FlyyingPiggy2020/fp-tool/Readme.md

MCU：ESP32-S3-N16R8

LCD: STT89V

目前V1.0版本已知问题：

改进问题：1.ESD管的封装太小，手工焊接困难.2.Boot ,Reset按键未加私印。3.TVS管买错了应该是双向TVS管。4.USB的GND没连。5.USBd+ d-接反。

前三个问题不致命，tvs就算不焊接目前调试阶段工作也完全是正常的。第四点需要自己在USB口小心点加一坨锡，好在GND是最外面的两个引脚，直接焊一坨锡上去就行。

d+ d-接反的问题也在新版本中解决，目前先跳线调试软件。

这些问题计划在2.0版本中改进~~（如果有2.0的话）~~
