FlyyingPiggy2020/fp-tool/Hardware/Readme.md

原理图和PCB使用ad21制作。

gerber文件是交付给板厂的生产文件。

改进问题：1.ESD管的封装太小.2.Boot ,Reset按键未加私印。3.TVS管买错了。4USB GND没连
