FlyyingPiggy2020/fp-tool/Document/1.69吋显示屏/LCD三视图2.png

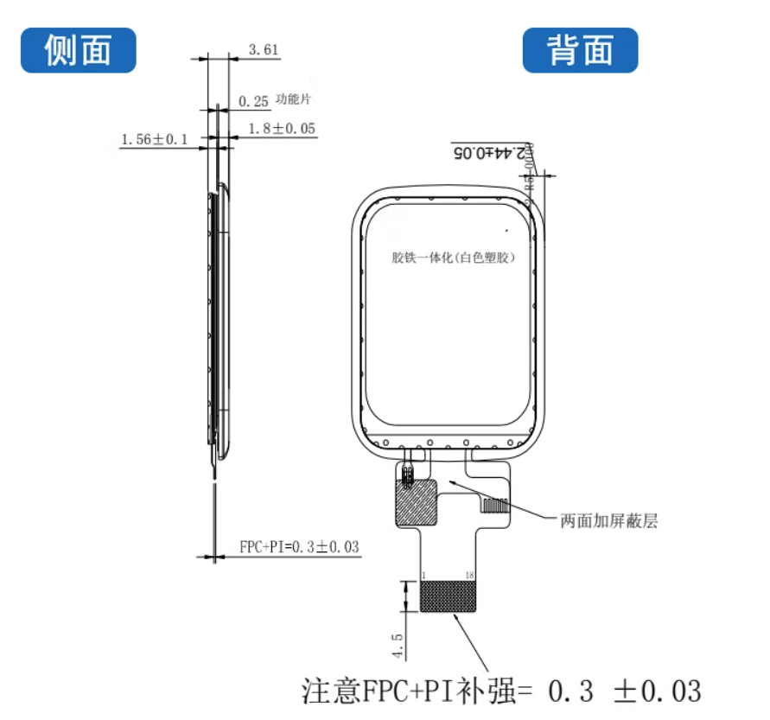
Document/1.69吋显示屏/LCD三视图2.png
