FlyyingPiggy2020/fp-tool/Document/1.69吋显示屏/LCD参数.png

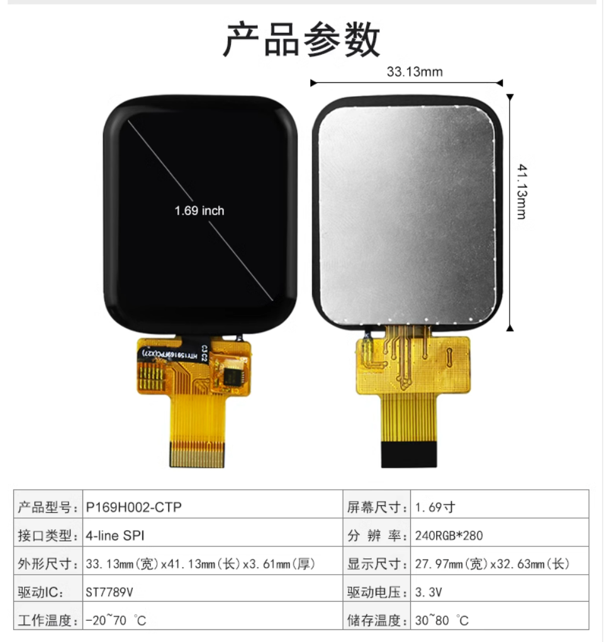
Document/1.69吋显示屏/LCD参数.png
