FlyyingPiggy2020/fp-tool/Hardware/fp-tool-bom.xlsx

Comment | Description | Designator | Footprint | LibRef | Quantity | 嘉立创物料编号
22uF | 贴片电容 | C1, C4, C7, C10, C13 | 0603_C | CAP_SMT | 5 | C2762594
1uF | 贴片电容 | C2 | 0603_C | CAP_SMT | 1 | C15849
47uF | 贴片电容 | C3, C6, C9, C12 | 0603_C | CAP_SMT | 4 | C140782
100nF | 贴片电容 | C5, C8, C11, C14,'C16, C18 | 0603_C | CAP_SMT | 6 | C14663
10uF | 贴片电容 | C15, C17 | 0603_C | CAP_SMT | 2 | C19702
B5819W |  | D1 | SOD-123F_L2.7-W1.6-LS3.8-RD-1 | B5819W | 1 | C2943878
LESD5D5.0CT1G |  | D2, D3, D4 | SOD-523_L1.2-W0.8-LS1.6-BI | LESD5D5.0CT1G | 3 | C383211
SMBJ6.0-170 | TVS | D5, D6, D7 | SMB(DO-214AA) - TVS | TVS | 3 | C726812
BAV99 |  | DN1 | SOT-23(SOT-23-3) | BAV99 | 1 | C82480
贴片自恢复保险丝 1812 0.1A 60V | Fuse | F1, F2 | 1206_R | Fuse 1 | 2 | C70064
FPC-05F-18PH20 |  | FPC1 | FPC-SMD_18P-P0.50_FPC-05F-18PH20 | FPC-05F-18PH20 | 1 | C2856802
DD1809E-RF | 平插 | M1 | DD1809(E)-RF-平 | DD1809E-RF | 1 | 白嫖
0R | Resistor | R1, R2, R3 | 0603_R | RES | 3 | C21189
5.1K | Resistor | R4, R5 | 0603_R | RES | 2 | C23186
100K | Resistor | R7, R8, R11, R17 | 0603_R | RES, Res1 | 4 | C25803
2K | Resistor | R9 | 0603_R | Res2 | 1 | C22975
1K | Resistor | R10, R14 | 0603_R | Res2 | 2 | C21190
47K | Resistor | R12 | 0603_R | Res2 | 1 | C25819
20R | Resistor | R13, R16 | 0603_R | Res2 | 2 | C22950
NC | Resistor | R15 | 0603_R | Res1 | 1 | NC
80R/100MHz_0603 | 磁珠 80R/100MHZ 贴片0603 | RB1 | 0603_R | 80R/100MHz_0603 | 1 | C62707
TS-1088-AR02016 | 轻触开关 | SW1, SW2 | SW-SMD_L3.9-W3.0-P4.45 | KEY | 2 | C720477
ESP32-S3-WROOM-1-N16R8 |  | U1 | WIRELM-SMD_ESP32-S3-WROOM-1 | ESP32-S3-WROOM-1-N16R8 | 1 | 优信电子
AP2112K-3.3TRG1 | 线性稳压器 | U2, U3 | SOT-25-5_L2.9-W1.6-P0.95-LS2.8-BL | AP2112K-3.3TRG1 | 2 | C51118
CA-IF4805HS | MAX485E | U4 | SOP8 | MAX485E | 1 | C2890054
WJ2EDGRM-5.08-4P | 连接器类型:板端/插座-闭口;间距:5.08mm;排数:1;每排PIN数:4;安装方式:弯针;颜色:绿色;固定方式:螺丝固定; | U5 | CONN-TH_4P-P5.08_WJ2EDGRM-5.08-4P-14-00A | WJ2EDGRM-5.08-4P | 1 | 插座：C122715 端子：C71372
TYPE-C 16PIN 2MD(073) |  | USB1 | USB-C-SMD_TYPE-C-6PIN-2MD-073 | TYPE-C 16PIN 2MD(073) | 1 | C2765186
AO3400A | 场效应管 | Q1 | SOT23-3 |  |  | C700953
