FlyyingPiggy2020/fp-tool/Document/LCD v1.step

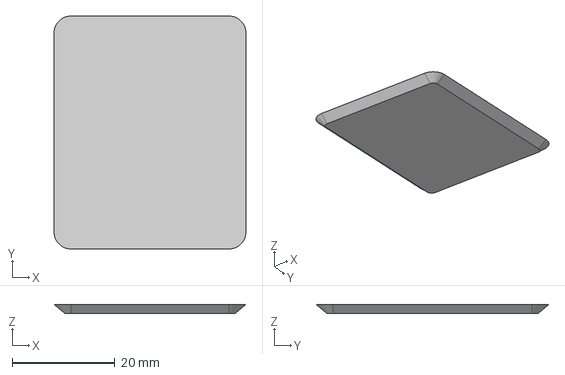
[picture p4: CAD file, 2023-09-26]
Document/LCD v1.step
37.4 x 45.4 x 1.80 mm
