FlyyingPiggy2020/fp-tool/Hardware/fp-tool-sch.pdf

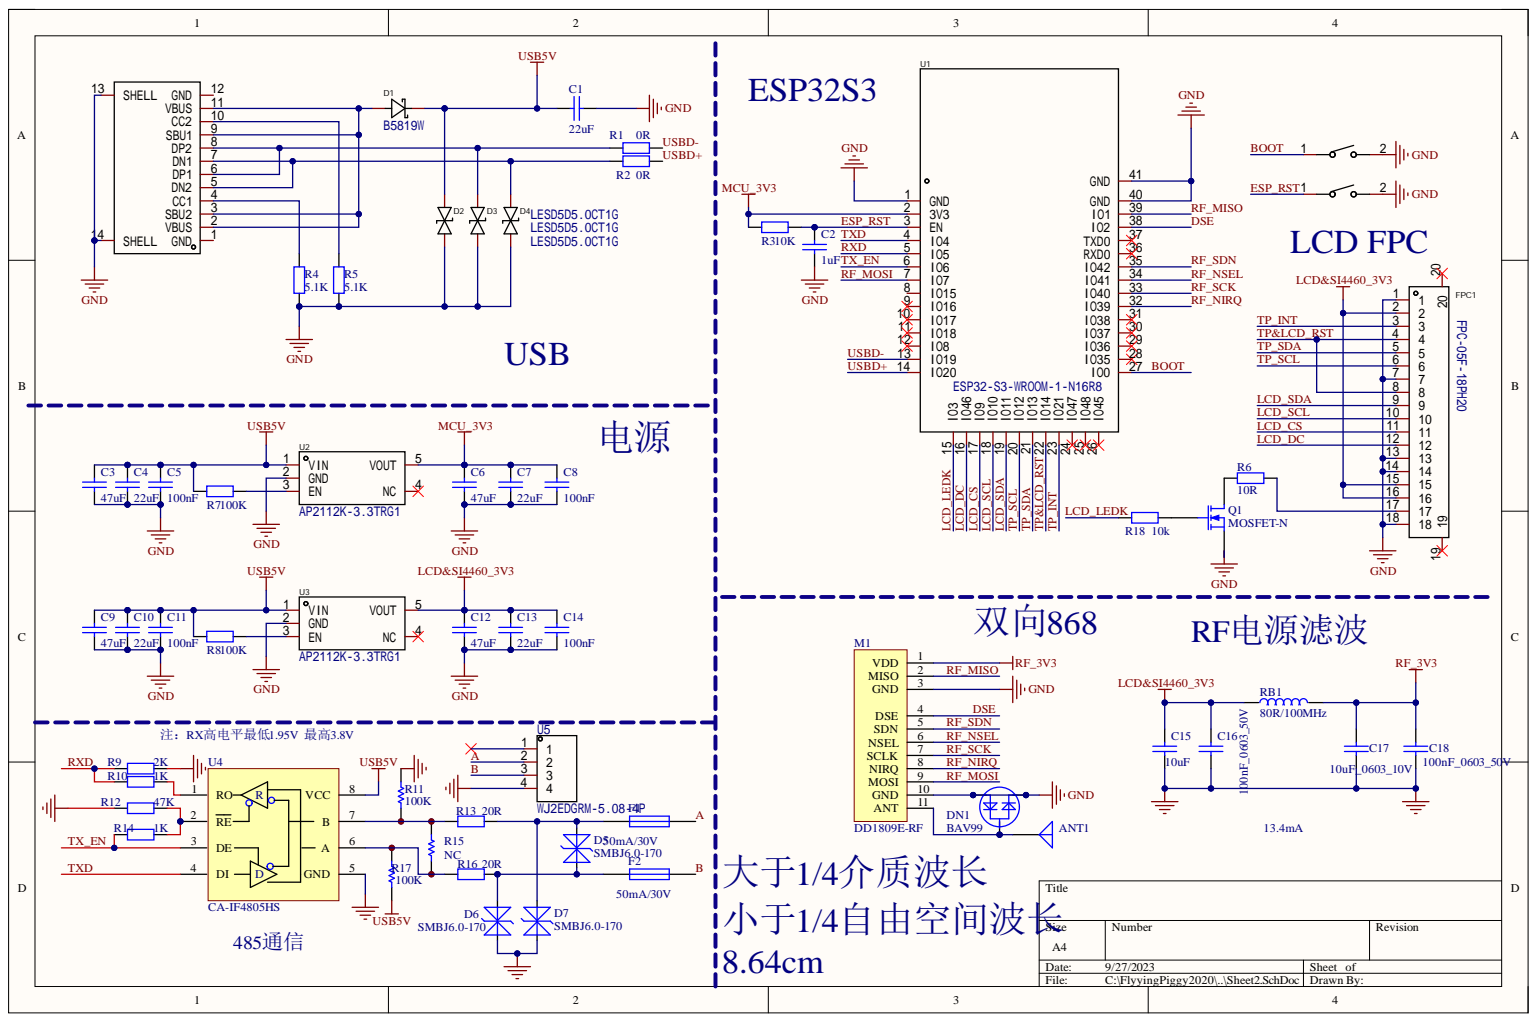
[picture p5: page 1]

14 14
15 15
16 16
