FlyyingPiggy2020/fp-tool/(list of files, drawings)

Other design files:
Hardware/project/Sheet1.SchDoc
Hardware/project/Sheet2.SchDoc
