FlyyingPiggy2020/fp-tool/(commit log)

2023-09-26 feat:add hard ware
    [LCD v1.step, PcbLib1.PcbLib, Schlib1.SchLib, Sheet1.SchDoc, Sheet2.SchDoc, fp_tool.PrjPcb]
2023-09-27 feat: finished pcb
    [PcbLib1.PcbLib, Schlib1.SchLib, Sheet2.SchDoc, fp_tool.PrjPcb, fp_tool.xlsx]
2023-09-27 doc:add reademe
    [PcbLib1.PcbLib, Schlib1.SchLib, Sheet1.SchDoc, Sheet2.SchDoc, fp-tool-bom.xlsx, fp_tool.PrjPcb, fp_tool.xlsx]
